huseyinynr1/STM32F4-DC-Motor-Controller-Hardware/Production/BOM/Bill of Materials-MotorController_STM32F4.xlsx

Comment | Description | Designator | Footprint | LibRef | Quantity | Manufacturer | Manufacturer Code | Capacitance | Resistance Value
100nF | MLCC (1608) 0603 100nF 50VDC ±10% X7R AUTOMOTIVE CL10B104KB85PNC | C1, C7, C8, C34 | CAP 0603 100NF | CAP 0603 100nF | 4 | SAMSUNG | CL10B104KB85PNC | 100nF
2.2µF | MLCC (1608) 0603 2.2uF 16VDC ±10% X5R CL10A225KO8NNNC | C2 | CAP 0603 2.2uF | CAP 0603 2.2uF | 1 | SAMSUNG | CL10A225KO8NNNC | 2.2µF
47µF | MLCC 1210 47uF 16VDC ±10% X5R CL32A476KOJNNNE | C3, C4 | CL32A476KOJNNNE | CAP 1210 47µF | 2 | SAMSUNG | CL32A476KOJNNNE | 47µF
100µF | CAP.EL.100µF 50V 10.5x10.5 105C SMD | C5, C25 | CAP_EEHZA1H101P | CAP 100µF | 2 | Panasonic | EEH-ZA1H101P | 100µF
4.7µF | MLCC (1608) 0603 4.7uF 35VDC ±10% X5R CL10A475KL8NRNC | C6 | CAP 0603 4.7uF | CAP 0603 4.7uF CL10A475KL8NRNC | 1 | SAMSUNG | CL10A475KL8NRNC | 4.7µF
10µF | CAP.EL.10uF 50V 5x5.8 105C 2000H AEC-Q200 SMT | C9 | CAP_EEEFK1H100UR | CAP 10µF Electrolytic | 1 | PANASONIC | EEEFK1H100UR | 10µF
150pF | MLCC (1608) 0603 150pF 50VDC ±5% C0G (NP0) CL10C151JB8NNNC | C10 | CAP 0603 150pF | CAP 0603 150pF | 1 | SAMSUNG | CL10C151JB8NNNC | 150pF
2.2µF | MLCC (1005) 0402 2.2uF 16VDC ±10% X5R CL05A225KO5NQNC | C11, C12 | CAP 0402 2.2UF | CAP 0402 2.2uF CL05A225KO5NQNC | 2 | SAMSUNG | CL05A225KO5NQNC | 2.2µF
1µF | MLCC (1005) 0402 1uF 16VDC ±10% X5R CL05A105KO5NNNC | C13, C15 | CAP 1uF 0402 | CAP 0402 1µF CL05A105KO5NNNC | 2 | SAMSUNG | CL05A105KO5NNNC | 1µF
100nF | MLCC (1005) 0402 100nF 16VDC ±10% X7R, MLCC (1005) 0402 100nF 16VDC ±10% X7R CL05B104KO5NNNC | C14, C16, C18, C19, C20, C21, C22, C23, C24 | CAP 100nF 0402 | CAP 0402 100nF, CAP 0402 100nF CL05B104KO5NNNC | 9 | SAMSUNG | CL05B104KO5NNNC | 100 nF
4.7µF | MLCC (1005) 0402 4.7uF 16VDC ±20% X5R CL05A475MO5LUNC | C17 | CAP 0402 4.7uF | CAP 0402 4.7uF CL05A475MO5LUNC | 1 | SAMSUNG | CL05A475MO5LUNC | 4.7µF
100nF | MLCC 0805 100nF 50VDC ±10% X7R | C26, C29, C32, C33 | CL21B104KBCNNNC | CAP 0805 100nF | 4 | SAMSUNG | CL21B104KBCNNNC | 100nF
2.2µF | MLCC 1206 2.2µF 50VDC ±10% X7R | C27, C28, C30, C31 | CAPC3216X180N | CAP 1206 2.2µF | 4 | SAMSUNG | CL31B225KBHVPNE | 2.2µF
B340AE-13 | DIODE SCHOTTKY 3A 40V SMA DO-214AC | D1 | DIODE B340AE-13 | DIODE SCHOTTKY B340AE-13 | 1 | DIODES | B340AE-13
SMBJ15A-HT | DIODE TVS 600W 15V DO214AA SMB | D2 | TVS DIODE SMBJ15A | DIODE TVS SMBJ15A-HT | 1 | HOTTECH | SMBJ15A-HT
LED GREEN | LED GREEN CLEAR CHIP SMD | D3, D5 | LED GREEN 0603 APT1608CGCK | SMD LED GREEN APT1608CGCK | 2 | KINGBRIGHT | APT1608CGCK
LED RED | LED SMD 0603 RED 617nm CLEAR CHIP SMD | D4 | LED RED 0603 APT1608EC | SMD LED RED APT1608EC | 1 | KINGBRIGHT | APT1608EC
BZT52C15-7-F | DIODE ZENER 500mW 15V ±5% SOD123 SMT | D6, D7 | DIODE ZENER BZT52C15-7-F | DIODE ZENER 15V BZT52C15-7-F | 2 | DIODES | BZT52C15-7-F
FUSE 4A | FUSE BOARD MOUNT 0805 4A 32VDC | F1 | FUSE 0805 MFU0805FF04000P100 | FUSE | 1 | VISHAY | MFU0805FF04000P100
BLM18PG221SN1D | FERRITE BEAD 0805 330R/100MHZ BLM18PG221SN1D SMD | FB1 | FB 0603 BLM18PG221SN1D | Ferrite Bead BLM18PG221SN1D | 1 | MURATA | BLM18PG221SN1D
2x1 5mm T.B. | TERM.BLK.5.00MM 2P PCB TYPE 0 BOY BLUE | J1, J3 | Terminal Block 2x1 | Terminal Block 2x1 | 2 | DEGSON | DG301-5.0-02P-12-00AH
Header 5x1 | PIN HEADER 5PIN (5x1) 2.54mm THT V/T | J2 | 5x1 Header | Header 5x1 for SWD | 1 | CONNFLY | DS1021-1X5SF11-B
Header 9x1 | PIN HEADER 5PIN (5x1) 2.54mm THT V/T | J4 | 9x1 Header | Header 9x1 | 1 | CONNFLY | DS1021-1X9SF11-B
Header 4x1 | PIN HEADER 5PIN (4x1) 2.54mm THT V/T | J5, J6 | 4x1 Header | Header 4x1 for Encoder | 2 | AMPHENOL | 68000-404HLF
68µH | INDUCTOR FIXED 68UH 10x10mm SMD 744066680 | L1 | IND CBC3225T680KR 68uH | INDUCTOR 68µH SMD 744066680 | 1 | WURTH | 744066680
PJD50P04 | MOSFET DIS.50A 40V P-CH AUTOMOTIVE TO-252AA SMT | Q1 | TO252 (DPAK) IRFR024NTRPBF | P-CH Mosfet 40V 9A PJD50P04-AU_L2_000A1 | 1 | PANJIT | PJD50P04-AU_L2_000A1
IRFR9024N | MOSFET DIS.11A 55V P-CH TO252(DPAK) HEXFET SMT | Q2, Q3 | TO252 (DPAK) IRFR024NTRPBF | P Channel Mosfet IRFR9024N | 2 | INFINEON | IRFR9024NTRPBF
MMBT2222A | TRANSISTOR DIS.600mA 40V NPN SOT23 EPITAXIAL SMT | Q4, Q5, Q10, Q11, Q12, Q13 | SOT23-3 MMBT2222A-HT | NPN Transistor MMBT2222A-HT | 6 | HOTTECH | MMBT2222A-HT
MMBT2907A | TRANSISTOR DIS.600mA 60V PNP SOT23 GEN. SMT | Q6, Q7 | TRANS_MMBT2907A | PNP Transistor MMBT2907A | 2 | PANJIT | MMBT2907A_R1_00001
IRFR024NTRPBF | MOSFET DIS.17A 55V N-CH TO252(DPAK) HEXFET SMT | Q8, Q9 | TO252 (DPAK) IRFR024NTRPBF | N Channel Mosfet IRFR024NTRPBF | 2 | IR | IRFR024NTRPBF
100k | RES.(1005) 0402 100K Ohms 1% 1/16W 100PPM 0402WGF1003TCE | R1 | RES 0402 ROYALOHM GENERAL | RES 0402 100k 0402WGF1003TCE | 1 | ROYALOHM | 0402WGF1003TCE |  | 100 k Ohms
10k | RES.(1005) 0402 10K Ohms 5% 1/16W 100PPM 0402WGJ0103TCE | R2, R3, R7, R9, R10, R13, R14, R19, R20, R33, R34 | RES 0402 ROYALOHM GENERAL | RES 0402 10k | 11 | ROYALOHM | 0402WGJ0103TCE |  | 10k Ohms
36k | RES.(1005) 0402 36K Ohms 1% 1/16W 100PPM 0402WGF3602TCE | R4 | RES 0402 ROYALOHM GENERAL | RES 0402 36k 0402WGF3602TCE | 1 | ROYALOHM | 0402WGF3602TCE |  | 36 k Ohms
1.8k | RES.(1005) 0402 1.8K Ohms 5% 1/16W 100PPM 0402WGJ0182TCE | R5 | RES 0402 ROYALOHM GENERAL | RES 0402 1.8k 0402WGJ0182TCE | 1 | ROYALOHM | 0402WGJ0182TCE |  | 1.8 k Ohms
3.24k | RES 0805 3.24k Ohms 1% 1/8W-S 100PPM 0402WGF3241TCE | R6 | RES 0402 ROYALOHM GENERAL | RES 0402 3.24k 0402WGF3241TCE | 1 | ROYALOHM | 0402WGF3241TCE |  | 3.24 k Ohms
4.7k | RES.(1608) 0603 4.7K Ohms 5% 1/10W-S 100PPM 0603SAJ0472T5E | R8 | ROYALOHM 0603 RES | RES 0402 4.7k 0603SAJ0472T5E | 1 | ROYALOHM | 0603SAJ0472T5E |  | 4.7k Ohms
360R | RES.(1608) 0603 360 Ohms 5% 1/10W-S 100PPM 0603SAJ0361T5E | R11 | ROYALOHM 0603 RES | RES 0603 360R 0603SAJ0361T5E | 1 | ROYALOHM | 0603SAJ0361T5E |  | 360 Ohms
330R | RES 0603 330 Ohms 5% 1/10W-S 100PPM | R12 | ROYALOHM 0603 RES | RES 0603 330R | 1 | ROYALOHM | 0603SAJ0331T5E |  | 330 Ohm
402R | RES.(2012) 0805 402 Ohms 1% 1/8W-S 100PPM 0805S8F4020T5E | R15, R16 | CHIP RES 0805 1k | RES 0805 402 Ohms 0402WGF4020TCE | 2 | ROYALOHM | 0805S8F4020T5E |  | 402 Ohms
2.2k | RES. 0805 2.2k Ohms 1% 1/8W-S 100PPM 0402WGF2201TCE | R17, R18 | RES 0402 ROYALOHM GENERAL | RES 0402 2.2k 0402WGF2201TCE | 2 | ROYALOHM | 0805S8F2201T5E |  | 2.2k Ohms
1k | RES.(1005) 0402 1K Ohms 1% 1/10W HP02WAF1001TCE | R21, R22, R25, R26, R27, R28 | RES 0402 ROYALOHM GENERAL | RES 0402 1k HP02WAF1001TCE | 6 | ROYALOHM | HP02WAF1001TCE |  | 1k Ohms
200R | RES.(2012) 0805 200 Ohms 5% 1/8W-S 100PPM 0805S8J0201T5E | R23, R24 | CHIP RES 0805 1k | RES 0805 200Ohms 0805S8J0201T5E | 2 | ROYALOHM | 0805S8J0201T5E |  | 200 Ohms
47k | RES.(1005) 0402 47K Ohms 1% 1/10W HP02WAF4702TCE | R29, R30, R31, R32 | RES 0402 ROYALOHM GENERAL | RES 0402 47k HP02WAF4702TCE | 4 | ROYALOHM | HP02WAF4702TCE |  | 47k Ohms
47R | RES. 0603 47 Ohms 1% 1/8W-S 100PPM | R35, R36, R37, R38 | ROYALOHM 0603 RES | RES 0603 47R | 4 | ROYALOHM | CQ03SAJ0470T5E |  | 47 Ohms
SWITCH | SWITCH TACT 6.00x6.00 8.00mm 160gF SMT V/T PTS647SM50SMTR2LFS | SW1 | PTS647SM50SMTR2 SMD BUTTON | SMD BUTTON PTS647SM50SMTR2LFS | 1 | LITTELFUSE-C&K | PTS647SM50SMTR2LFS
TPS5410D | IC-5410DR REG BUCK ADJ 1A 8SOIC SMD TI | U1 | SOIC127TPS5410DR | Buck Converter TPS5410D | 1 | TEXAS TI | TPS5410D
L4931ABD33-TR | IC REG LINEAR 3.3V 250MA 8SO L4931ABD33 | U2 | LDO L4931ABD33-TR SOIC8 | LDO L4931ABD33 | 1 | STM | L4931ABD33
STM32F407VET6 | IC-32F407V MCU 32BIT 512KB FLASH 100LQFP | U3 | LQFP100-0.5-13.8X13.8MM | MCU-STM32F407VET6(LQFP100) | 1 | STM | STM32F407VET6TR
