huseyinynr1/STM32F4-DC-Motor-Controller-Hardware/(list of files, drawings)

Other design files:
Design_Files/MCU.SchDoc
Design_Files/Motor_Controller.SchDoc
Design_Files/MotorController_STM32F4.PrjPcb
Design_Files/Power.SchDoc
Design_Files/Sensors_and_External_Interfaces.SchDoc
